wmasterj/Minai-Printer/hardware/enclosure/viewer.html

# Minai Printer enclosure

rev 0.1

Closed Lid open Inside Exploded

Drag to rotate · scroll or pinch to zoom · right-drag to pan

## Pose

Lid angle 0° Pull apart 0% See-through shell Outline edges

## Parts

## Read this first

- The print mechanism is a stand-in block (70 × 31 × 16 mm, assumed). Its posts, the paper slot and the platen roller position must be redrawn around the real part.
- Paper path: roll in the front bay, up past the mechanism, out of the slot on top, torn against the serrated bar.
- The button is translucent and is lit from below by the board's LED.
- USB-C is on the back, lined up with the socket on the board.
