wmasterj/Minai-Printer/hardware/outputs/board-3d-bottom.png

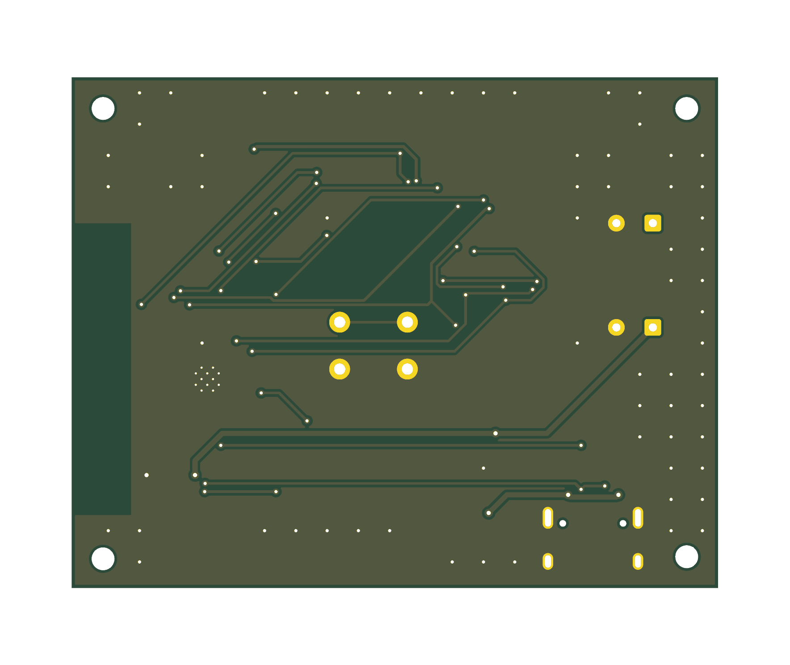
hardware/outputs/board-3d-bottom.png
