wmasterj/Minai-Printer/hardware/outputs/bom.md

| Designators | Qty | Value | Description | Part number | Links |
|---|---|---|---|---|---|
| C1 | 1 | 22uF | Capacitor 22uF 10V X5R 0805 | generic | [LCSC](https://www.lcsc.com/search?q=22uF%200805%20capacitor) · [DigiKey](https://www.digikey.com/en/products/result?keywords=22uF%200805%20capacitor) |
| C2 | 1 | 100uF 10V | Aluminium electrolytic 100uF 10V, 6.3x5.4 mm SMD | generic | [LCSC](https://www.lcsc.com/search?q=100uF%2010V%20Elec%20capacitor) · [DigiKey](https://www.digikey.com/en/products/result?keywords=100uF%2010V%20Elec%20capacitor) |
| C3 C7 | 2 | 1uF | Capacitor 1uF 16V X7R 0603 | generic | [LCSC](https://www.lcsc.com/search?q=1uF%200603%20capacitor) · [DigiKey](https://www.digikey.com/en/products/result?keywords=1uF%200603%20capacitor) |
| C4 C6 C13 C19 | 4 | 10uF | Capacitor 10uF 10V X5R 0805 | generic | [LCSC](https://www.lcsc.com/search?q=10uF%200805%20capacitor) · [DigiKey](https://www.digikey.com/en/products/result?keywords=10uF%200805%20capacitor) |
| C5 C8 C9 C10 C14 C15 C17 C18 C20 C23 | 10 | 100nF | Capacitor 100nF 16V X7R 0603 | generic | [LCSC](https://www.lcsc.com/search?q=100nF%200603%20capacitor) · [DigiKey](https://www.digikey.com/en/products/result?keywords=100nF%200603%20capacitor) |
| C11 C12 | 2 | 1000uF | Aluminium electrolytic 1000uF 10V low-ESR, 8 mm dia, 3.5 mm pitch | generic | [LCSC](https://www.lcsc.com/search?q=1000uF%20Radial%20capacitor) · [DigiKey](https://www.digikey.com/en/products/result?keywords=1000uF%20Radial%20capacitor) |
| C21 | 1 | 2.2uF | Capacitor 2.2uF 16V X7R 0603 | generic | [LCSC](https://www.lcsc.com/search?q=2.2uF%200603%20capacitor) · [DigiKey](https://www.digikey.com/en/products/result?keywords=2.2uF%200603%20capacitor) |
| C22 | 1 | 10nF | Capacitor 10nF 16V X7R (charge pump) | generic | [LCSC](https://www.lcsc.com/search?q=10nF%200603%20capacitor) · [DigiKey](https://www.digikey.com/en/products/result?keywords=10nF%200603%20capacitor) |
| D1 | 1 | B5819W | Schottky diode 40V 1A SOD-123 | B5819W | [LCSC](https://www.lcsc.com/search?q=B5819W) · [DigiKey](https://www.digikey.com/en/products/result?keywords=B5819W) |
| D2 | 1 | SK6812MINI | Addressable RGB LED 3535 | SK6812MINI | [LCSC](https://www.lcsc.com/search?q=SK6812MINI) · [DigiKey](https://www.digikey.com/en/products/result?keywords=SK6812MINI) |
| F1 | 1 | 2.6A PTC | Resettable fuse, 2.6 A hold, 1812 | 1812L260/16 | [LCSC](https://www.lcsc.com/search?q=1812L260) · [DigiKey](https://www.digikey.com/en/products/result?keywords=1812L260) |
| J1 | 1 | USB-C 16P | USB Type-C receptacle, 16 pin, USB 2.0, SMT | TYPE-C-31-M-12 | [LCSC](https://www.lcsc.com/search?q=TYPE-C-31-M-12) · [DigiKey](https://www.digikey.com/en/products/result?keywords=TYPE-C-31-M-12) |
| J2 | 1 | FTP-628MCL101 / PT486F | FFC/FPC connector 30 pos 1.0 mm pitch, right angle ZIF | 200528-0300 (Fujitsu specifies Molex 52610-3071) | [LCSC](https://www.lcsc.com/search?q=200528-0300) · [DigiKey](https://www.digikey.com/en/products/result?keywords=200528-0300) |
| Q1 | 1 | AO3401A | P-channel MOSFET 30V 4A, VH high-side switch | AO3401A | [LCSC](https://www.lcsc.com/search?q=AO3401A) · [DigiKey](https://www.digikey.com/en/products/result?keywords=AO3401A) |
| Q2 | 1 | 2N7002 | N-channel MOSFET 60V, level shifter | 2N7002 | [LCSC](https://www.lcsc.com/search?q=2N7002) · [DigiKey](https://www.digikey.com/en/products/result?keywords=2N7002) |
| R1 R2 | 2 | 5.1k | Resistor 5.1k 0603 | generic | [LCSC](https://www.lcsc.com/search?q=5.1k%200603%20resistor) · [DigiKey](https://www.digikey.com/en/products/result?keywords=5.1k%200603%20resistor) |
| R3 R4 R5 R6 R7 R8 R9 | 7 | 10k | Resistor 10k 0603 | generic | [LCSC](https://www.lcsc.com/search?q=10k%200603%20resistor) · [DigiKey](https://www.digikey.com/en/products/result?keywords=10k%200603%20resistor) |
| R10 | 1 | 150k | Resistor 150k 0603 | generic | [LCSC](https://www.lcsc.com/search?q=150k%200603%20resistor) · [DigiKey](https://www.digikey.com/en/products/result?keywords=150k%200603%20resistor) |
| R11 | 1 | 1M | Resistor 1M 0603 | generic | [LCSC](https://www.lcsc.com/search?q=1M%200603%20resistor) · [DigiKey](https://www.digikey.com/en/products/result?keywords=1M%200603%20resistor) |
| R12 | 1 | 100k 1% | Resistor 100k 1% 0603 | generic | [LCSC](https://www.lcsc.com/search?q=100k%200603%20resistor) · [DigiKey](https://www.digikey.com/en/products/result?keywords=100k%200603%20resistor) |
| R13 | 1 | 68k 1% | Resistor 68k 1% 0603 | generic | [LCSC](https://www.lcsc.com/search?q=68k%200603%20resistor) · [DigiKey](https://www.digikey.com/en/products/result?keywords=68k%200603%20resistor) |
| R14 | 1 | 220R | Resistor 220R (paper sensor LED current) | generic | [LCSC](https://www.lcsc.com/search?q=220R%200603%20resistor) · [DigiKey](https://www.digikey.com/en/products/result?keywords=220R%200603%20resistor) |
| R15 | 1 | 47k | Resistor 47k (paper sensor load) | generic | [LCSC](https://www.lcsc.com/search?q=47k%200603%20resistor) · [DigiKey](https://www.digikey.com/en/products/result?keywords=47k%200603%20resistor) |
| R16 | 1 | 30k 1% | Resistor 30k 1% (thermistor divider) | generic | [LCSC](https://www.lcsc.com/search?q=30k%200603%20resistor) · [DigiKey](https://www.digikey.com/en/products/result?keywords=30k%200603%20resistor) |
| R17 R18 | 2 | 0.2R | Current-sense resistor 0.2 ohm 1% 0805 (1 A limit) | generic | [LCSC](https://www.lcsc.com/search?q=0.2R%200805%20resistor) · [DigiKey](https://www.digikey.com/en/products/result?keywords=0.2R%200805%20resistor) |
| SW1 | 1 | BTN / BOOT | Tactile switch 6x6 mm through-hole; actuator height to suit keycap | TS-1187 / B3F class | [LCSC](https://www.lcsc.com/search?q=TS-1187) · [DigiKey](https://www.digikey.com/en/products/result?keywords=TS-1187) |
| U1 | 1 | ESP32-C3-WROOM-02-N4 | Wi-Fi + Bluetooth LE module, RISC-V, 4 MB flash, PCB antenna | ESP32-C3-WROOM-02-N4 | [maker](https://www.espressif.com/en/products/modules/esp32-c3) · [LCSC](https://www.lcsc.com/search?q=ESP32-C3-WROOM-02-N4) · [DigiKey](https://www.digikey.com/en/products/result?keywords=ESP32-C3-WROOM-02-N4) |
| U2 | 1 | AP2112K-3.3 | 3.3 V 600 mA low-dropout regulator | AP2112K-3.3TRG1 | [maker](https://www.diodes.com/part/view/AP2112) · [LCSC](https://www.lcsc.com/search?q=AP2112K-3.3TRG1) · [DigiKey](https://www.digikey.com/en/products/result?keywords=AP2112K-3.3TRG1) |
| U3 | 1 | DRV8833PW | Dual H-bridge motor driver, 1.5 A, TSSOP-16 | DRV8833PWR | [maker](https://www.ti.com/product/DRV8833) · [LCSC](https://www.lcsc.com/search?q=DRV8833PWR) · [DigiKey](https://www.digikey.com/en/products/result?keywords=DRV8833PWR) |
| U4 | 1 | 74LVC2G04 | Dual inverter, generates complementary motor phase signals | 74LVC2G04GW | [maker](https://www.nexperia.com/product/74LVC2G04GW) · [LCSC](https://www.lcsc.com/search?q=74LVC2G04GW) · [DigiKey](https://www.digikey.com/en/products/result?keywords=74LVC2G04GW) |
| U5 | 1 | USBLC6-2SC6 | USB ESD protection diode array | USBLC6-2SC6 | [maker](https://www.st.com/en/protection-devices/usblc6-2.html) · [LCSC](https://www.lcsc.com/search?q=USBLC6-2SC6) · [DigiKey](https://www.digikey.com/en/products/result?keywords=USBLC6-2SC6) |
