wmasterj/Minai-Printer/hardware/enclosure/out/minai-printer-assembly.step

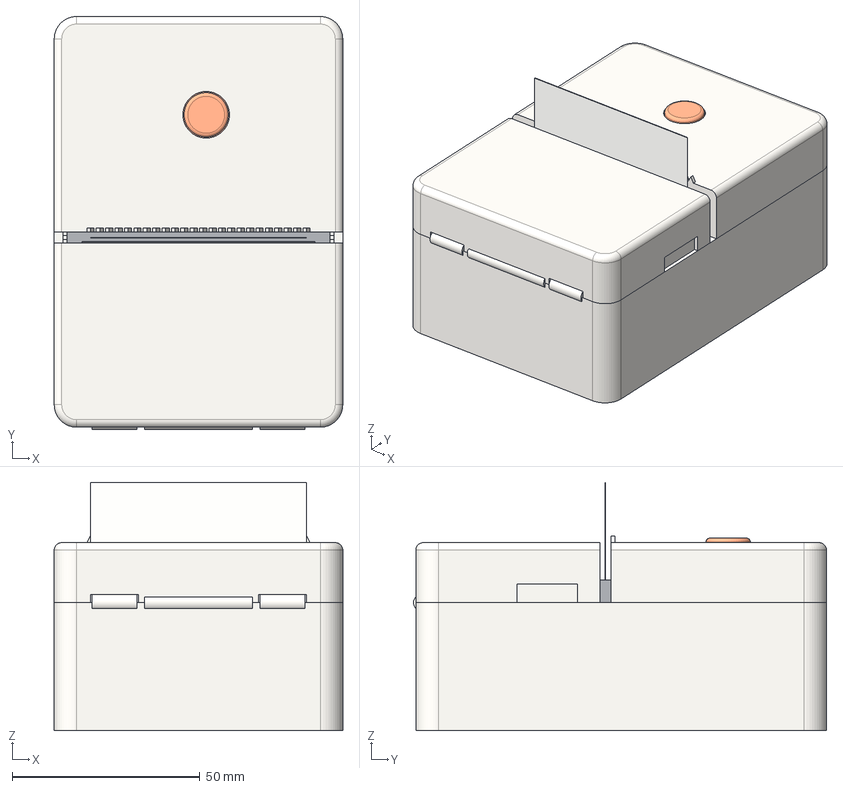
[picture p10: CAD file, 2026-11-10]
hardware/enclosure/out/minai-printer-assembly.step
76.8 x 109.9 x 66.0 mm
base
lid
rear-cover
button
platen-roller
main-board
board-parts
print-mechanism
paper-roll
paper
