wmasterj/Minai-Printer/hardware/enclosure/out/base.step

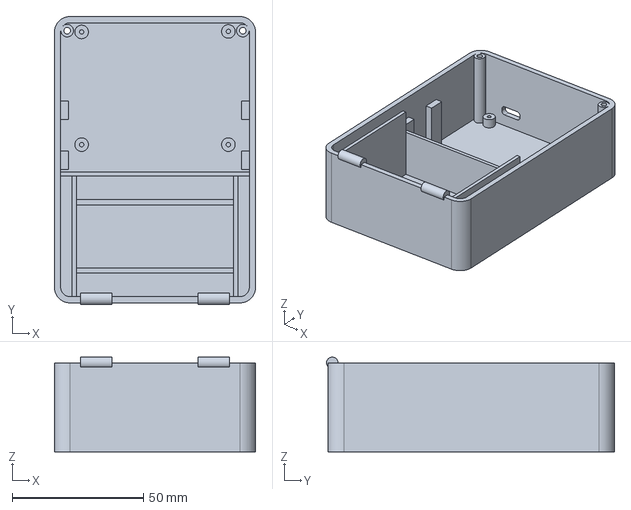
[picture p11: CAD file, 2026-11-10]
hardware/enclosure/out/base.step
76.8 x 109.9 x 36.2 mm
