wmasterj/Minai-Printer/hardware/enclosure/out/lid.step

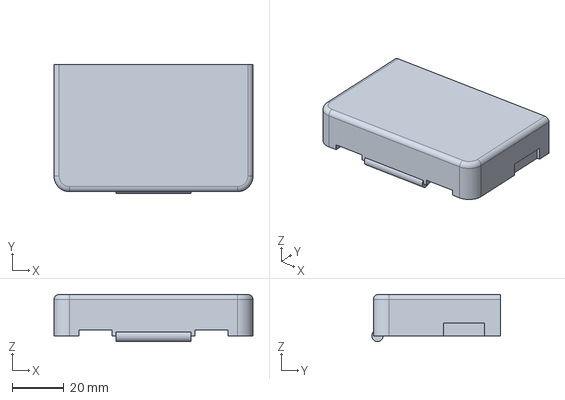
[picture p12: CAD file, 2026-11-10]
hardware/enclosure/out/lid.step
76.8 x 49.6 x 18.2 mm
