wmasterj/Minai-Printer/hardware/enclosure/out/button.step

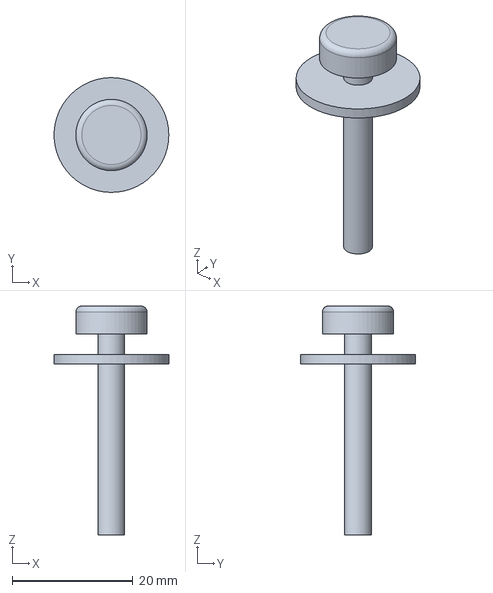
[picture p13: CAD file, 2026-11-10]
hardware/enclosure/out/button.step
19.0 x 19.0 x 37.9 mm
