wmasterj/Minai-Printer/hardware/enclosure/out/rear-cover.step

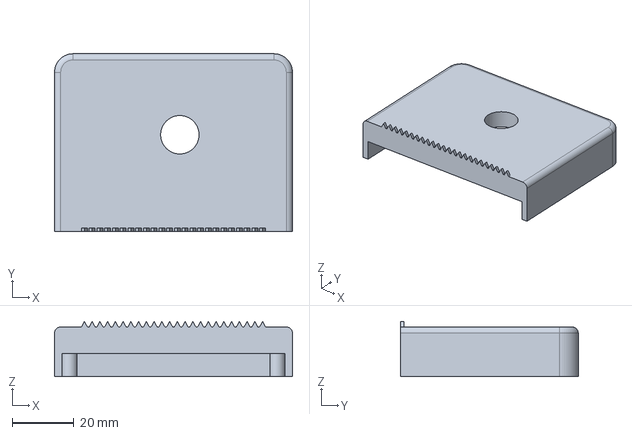
[picture p14: CAD file, 2026-11-10]
hardware/enclosure/out/rear-cover.step
76.8 x 57.3 x 17.8 mm
