wmasterj/Minai-Printer/(list of files, cad)

Other CAD files:
hardware/enclosure/out/base.stl
hardware/enclosure/out/button.stl
hardware/enclosure/out/lid.stl
hardware/enclosure/out/rear-cover.stl
