wmasterj/Minai-Printer/hardware/outputs/schematic.pdf

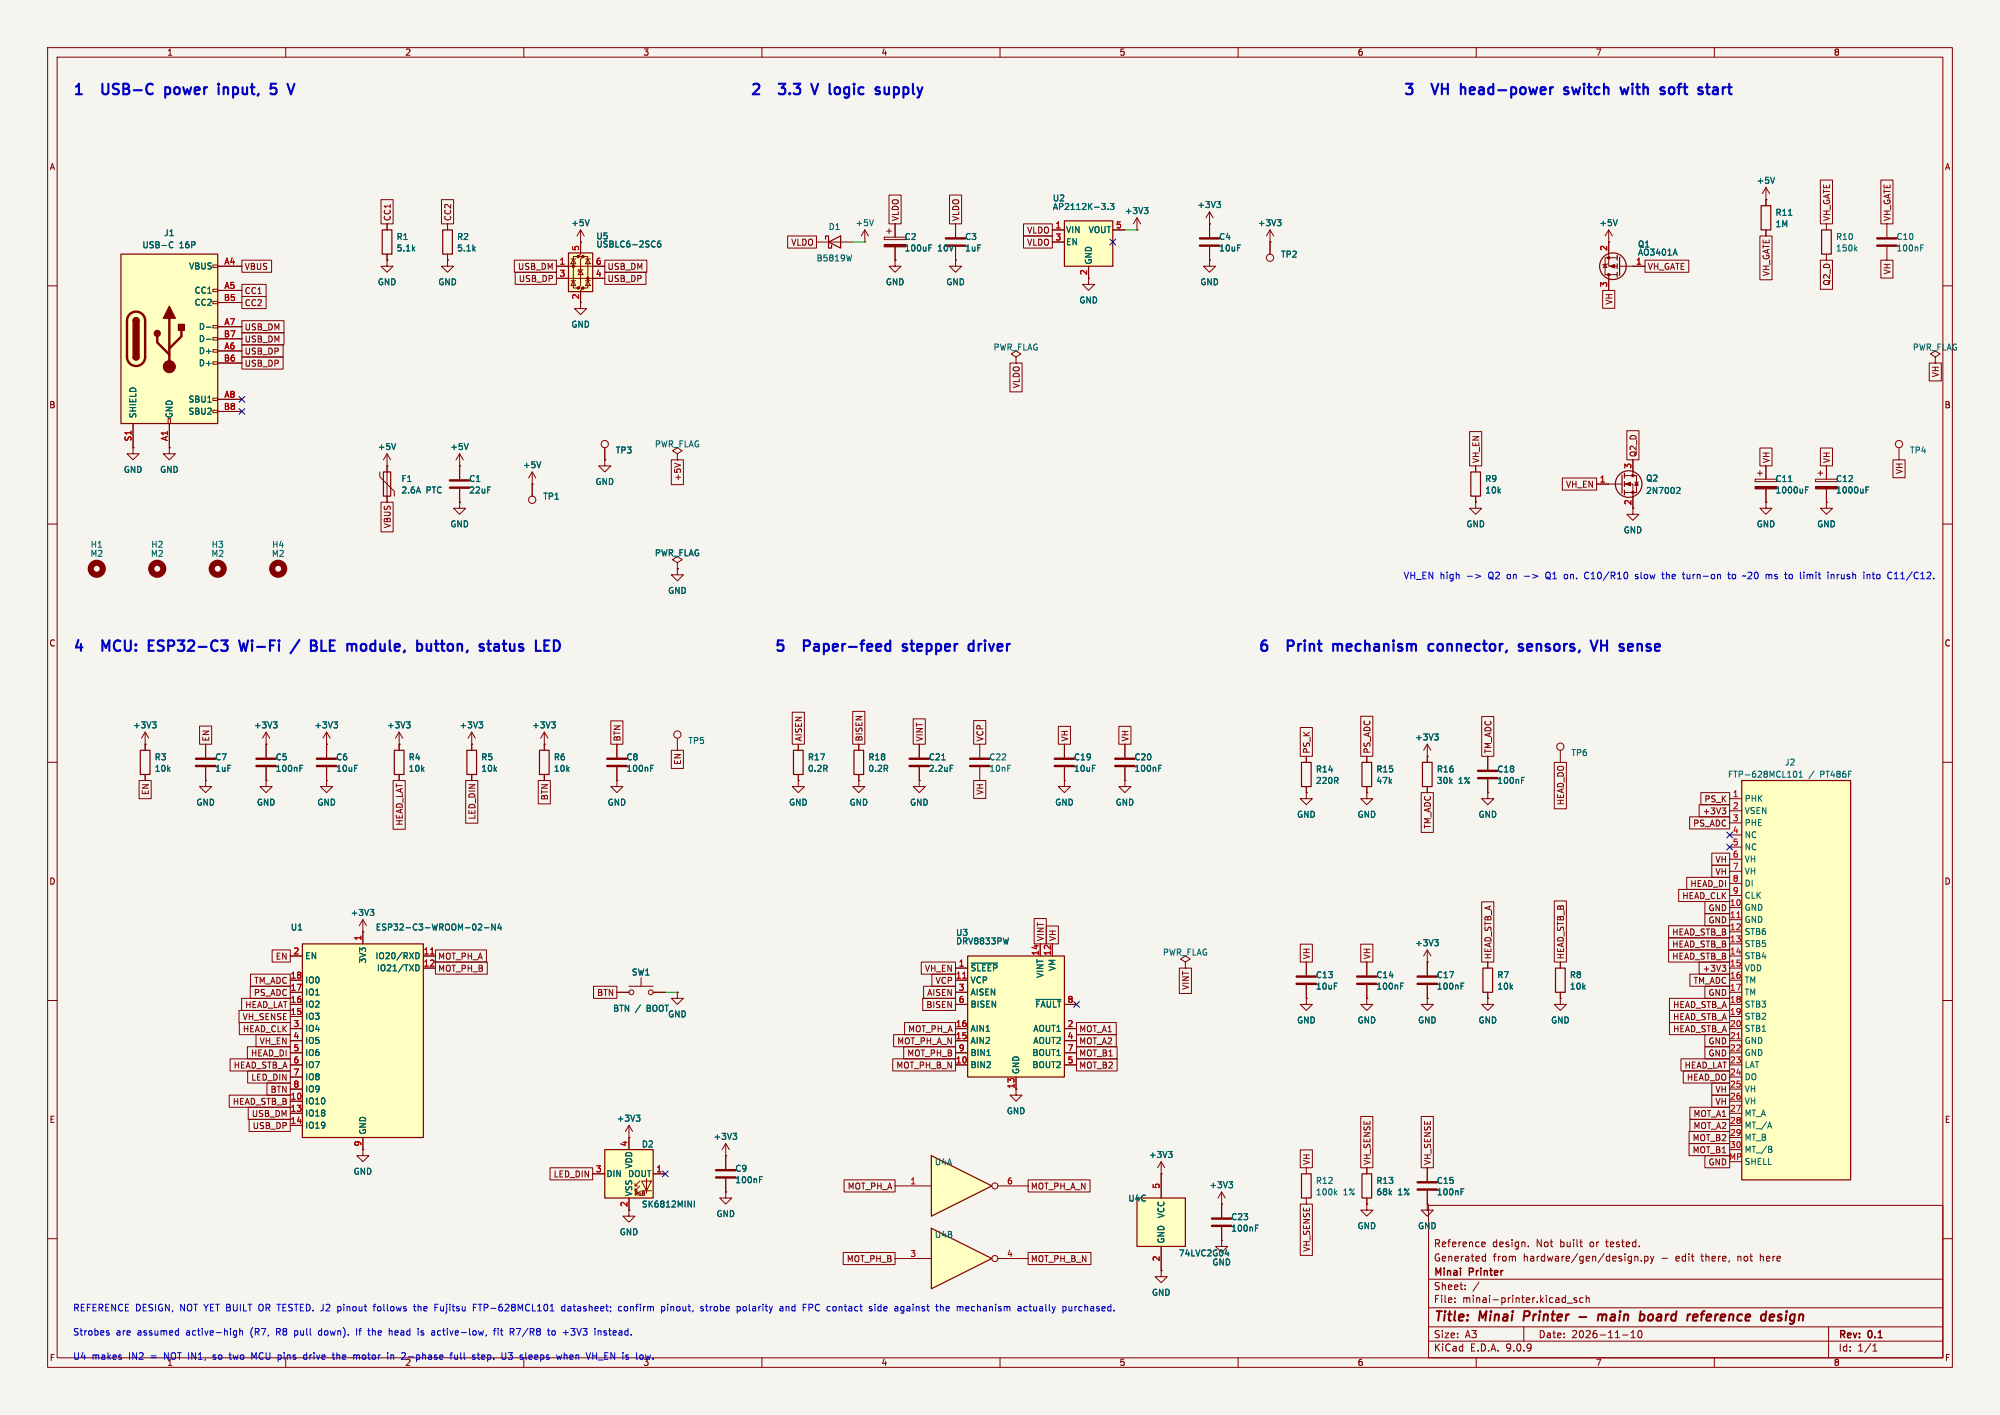
[picture p15: page 1]

Id: 1/1 Title: Minai Printer - main board reference design
