wmasterj/Minai-Printer/hardware/outputs/board-bottom.pdf

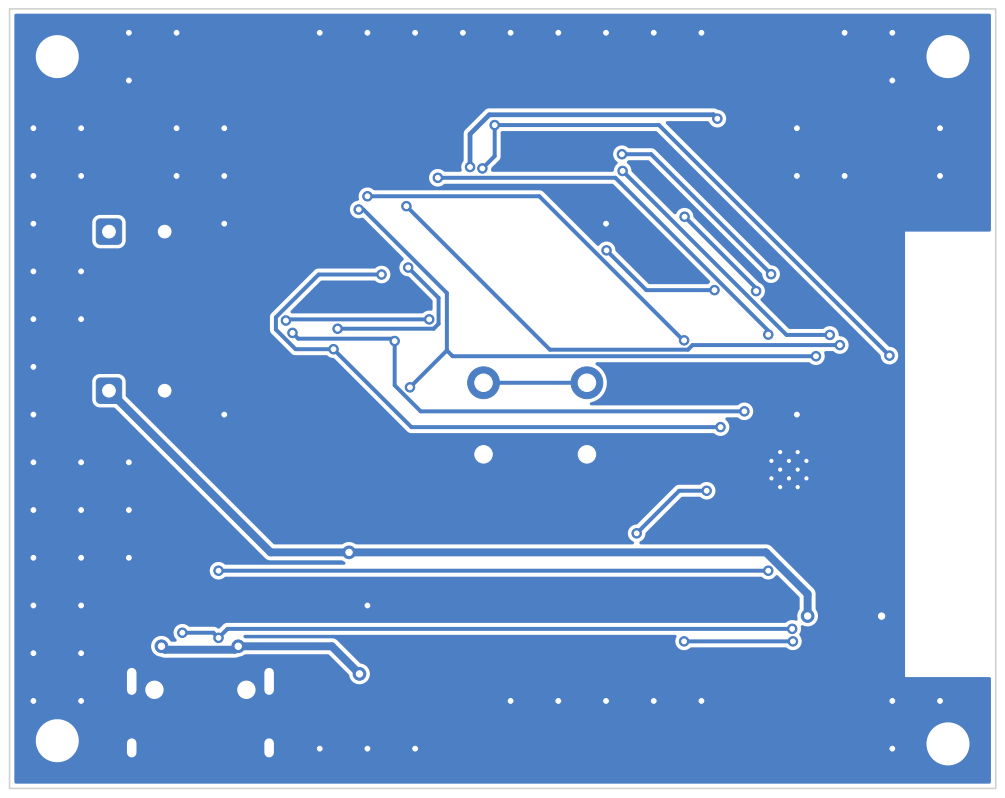
[picture p16: page 1]
