wmasterj/Minai-Printer/hardware/outputs/board-top.pdf

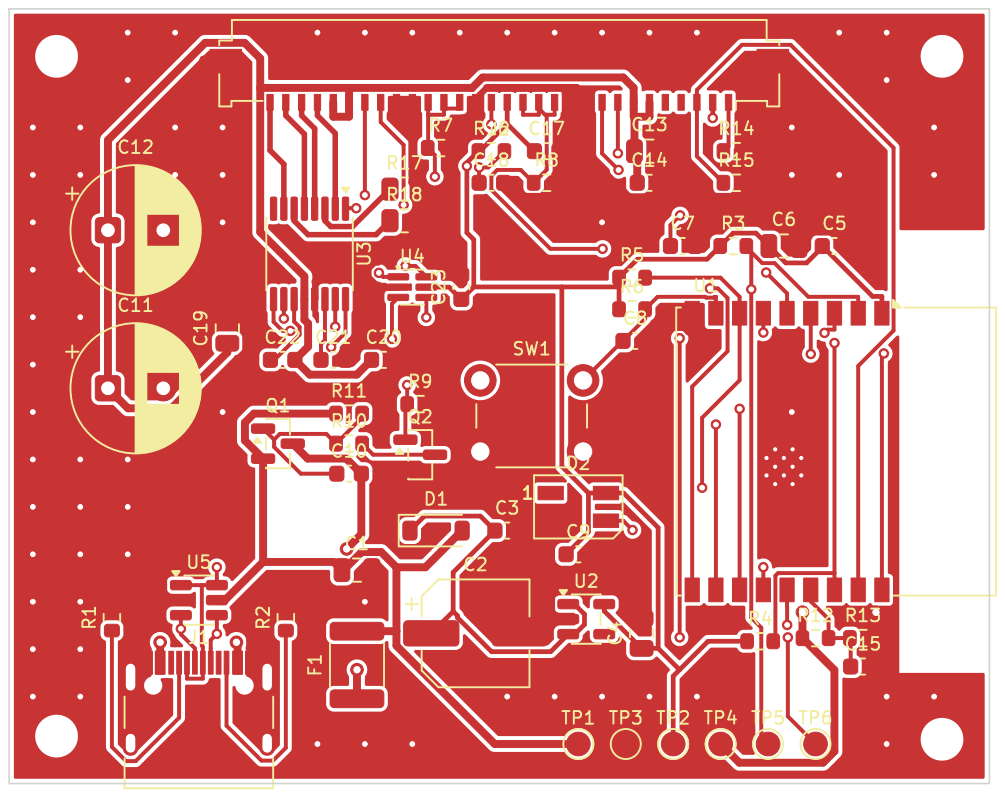
[picture p17: page 1]
