wmasterj/Minai-Printer/hardware/kicad/minai-printer.kicad_pcb

## KiCad design hardware/kicad/minai-printer.kicad_pcb (2026-11-10)

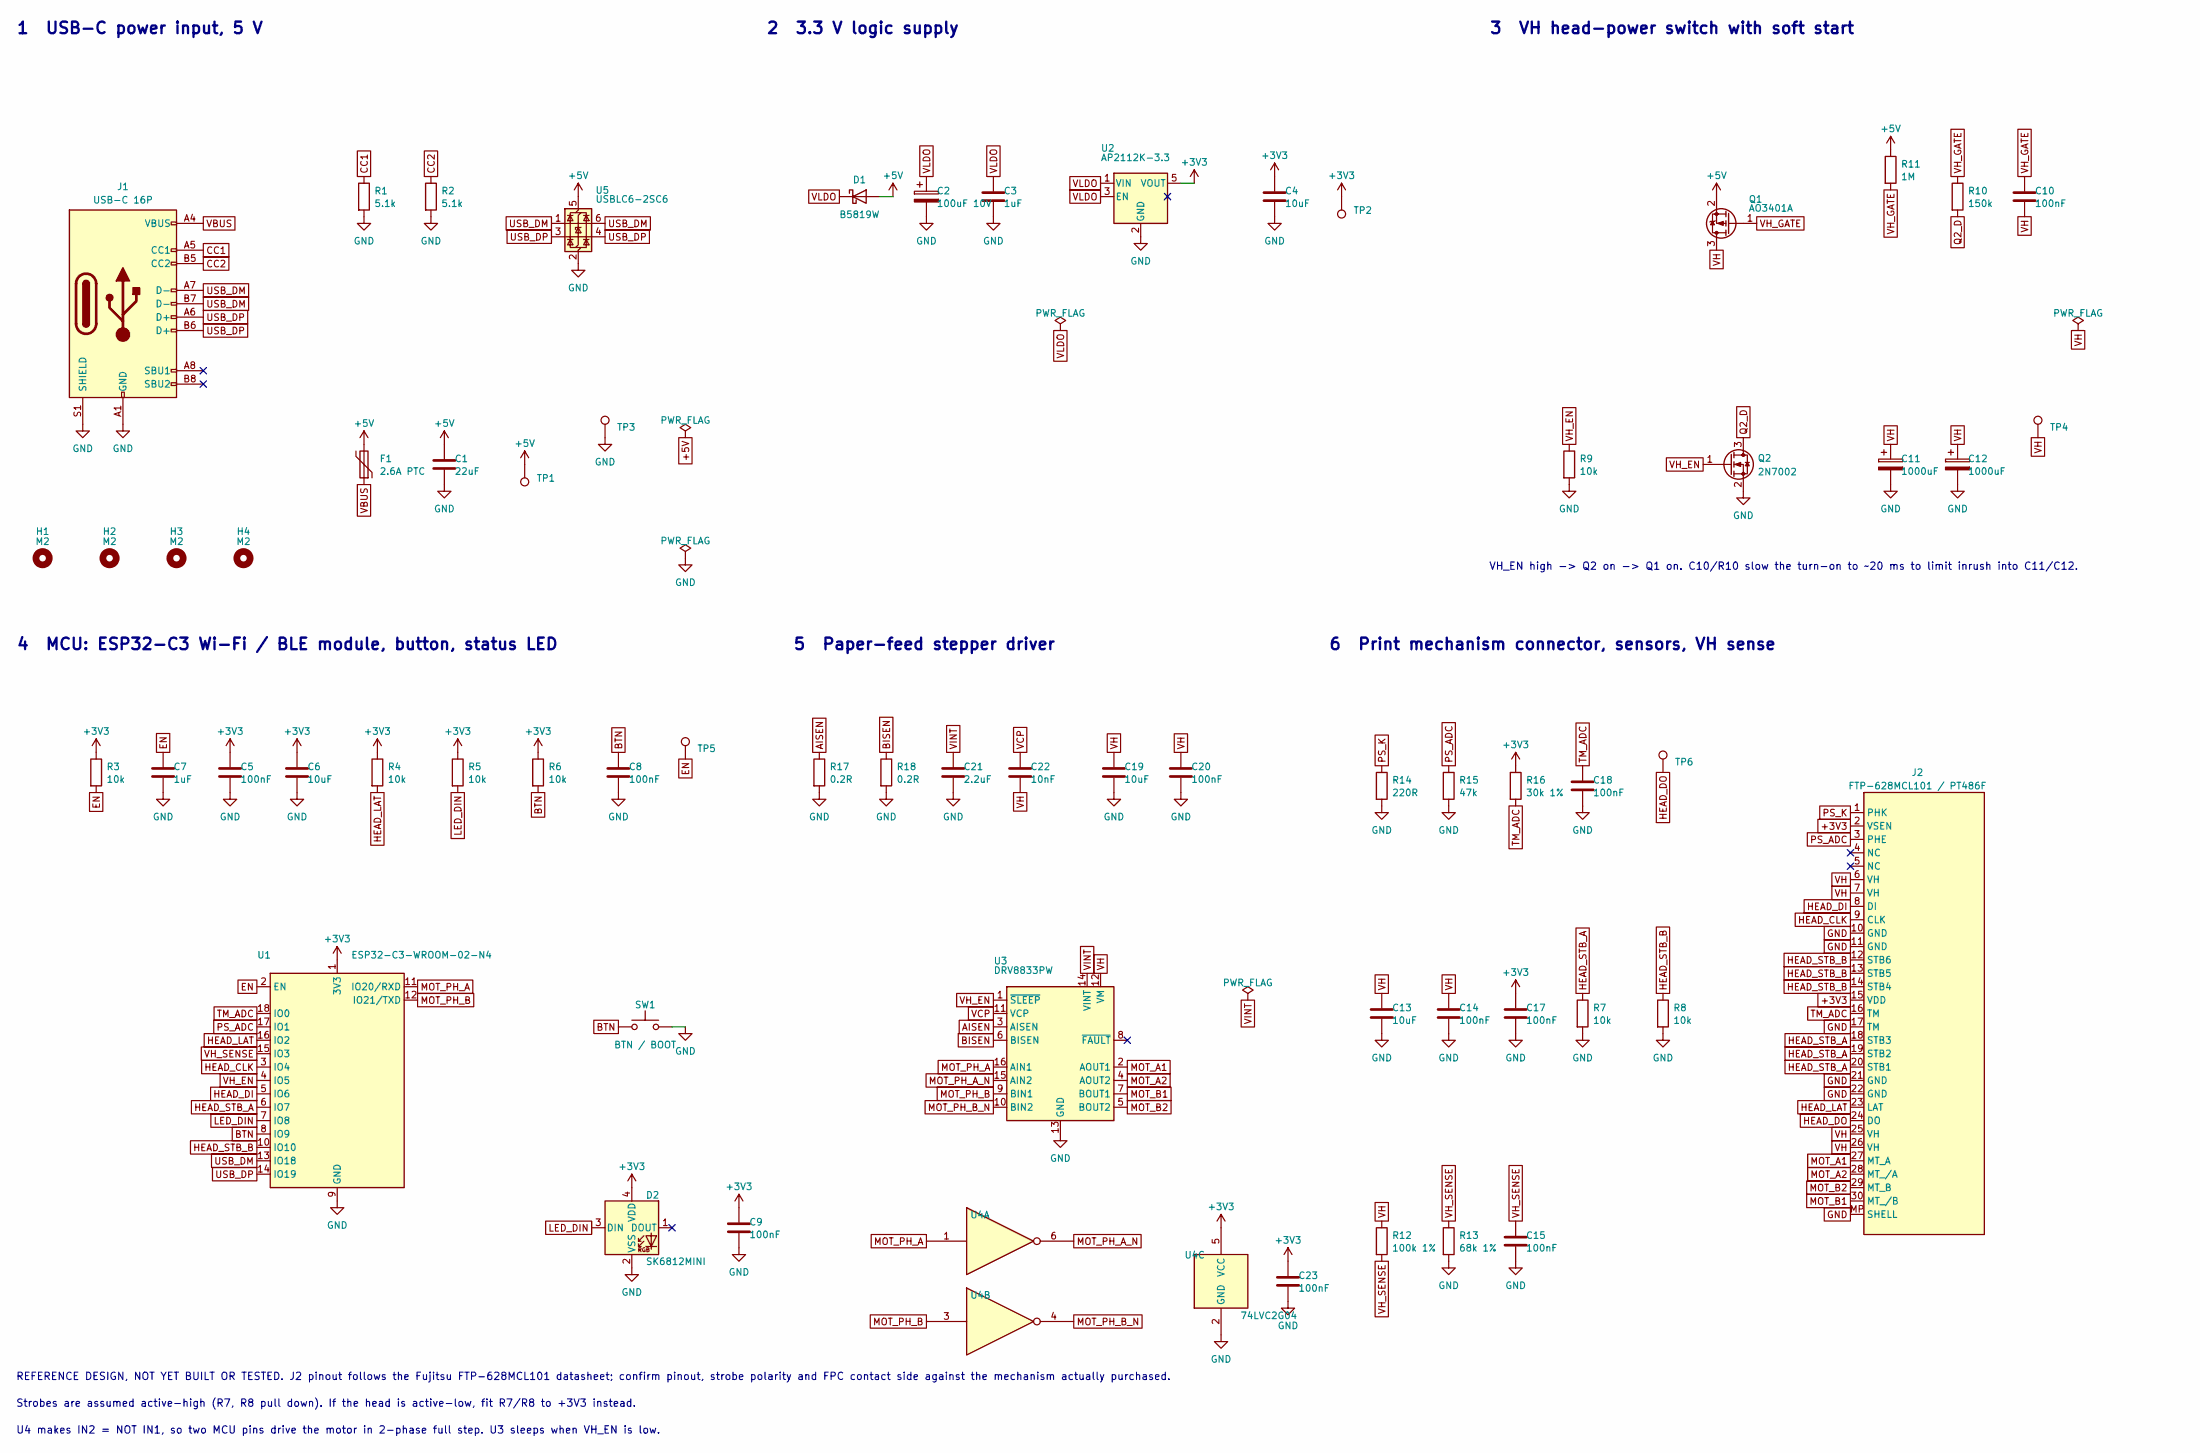
[picture p18: schematic minai-printer.kicad_sch, Minai Printer - main board reference design]

Parts:
C1: 22uF; C_0805_2012Metric
C2: 100uF 10V; CP_Elec_6.3x5.4
C3, C7: 1uF; C_0603_1608Metric
C4, C6, C13, C19: 10uF; C_0805_2012Metric
C5, C8, C9, C10, C14, C15, C17, C18, C20, C23: 100nF; C_0603_1608Metric
C11, C12: 1000uF; CP_Radial_D8.0mm_P3.50mm
C21: 2.2uF; C_0603_1608Metric
C22: 10nF; C_0603_1608Metric
D1: B5819W; D_SOD-123; MPN B5819W
D2: SK6812MINI; LED_SK6812MINI_PLCC4_3.5x3.5mm_P1.75mm; MPN SK6812MINI
F1: 2.6A PTC; Fuse_1812_4532Metric; MPN 1812L260/16
H1, H2, H3, H4: M2; MountingHole_2.2mm_M2
J1: USB-C 16P; USB_C_Receptacle_HRO_TYPE-C-31-M-12; MPN TYPE-C-31-M-12
J2: FTP-628MCL101 / PT486F; Molex_200528-0300_1x30-1MP_P1.00mm_Horizontal; MPN 200528-0300 (Fujitsu specifies Molex 52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
Q1: AO3401A; SOT-23; MPN AO3401A
Q2: 2N7002; SOT-23; MPN 2N7002
R1, R2: 5.1k; R_0603_1608Metric
R3, R4, R5, R6, R7, R8, R9: 10k; R_0603_1608Metric
R10: 150k; R_0603_1608Metric
R11: 1M; R_0603_1608Metric
R12: 100k 1%; R_0603_1608Metric
R13: 68k 1%; R_0603_1608Metric
R14: 220R; R_0603_1608Metric
R15: 47k; R_0603_1608Metric
R16: 30k 1%; R_0603_1608Metric
R17, R18: 0.2R; R_0805_2012Metric
SW1: BTN / BOOT; SW_PUSH_6mm; MPN TS-1187 / B3F class
TP1: +5V; TestPoint_Pad_D1.5mm
TP2: +3V3; TestPoint_Pad_D1.5mm
TP3: GND; TestPoint_Pad_D1.5mm
TP4: VH; TestPoint_Pad_D1.5mm
TP5: EN; TestPoint_Pad_D1.5mm
TP6: HEAD_DO; TestPoint_Pad_D1.5mm
U1: ESP32-C3-WROOM-02-N4; ESP32-C3-WROOM-02; MPN ESP32-C3-WROOM-02-N4
U2: AP2112K-3.3; SOT-23-5; MPN AP2112K-3.3TRG1
U3: DRV8833PW; TSSOP-16_4.4x5mm_P0.65mm; MPN DRV8833PWR
U4: 74LVC2G04; SOT-363_SC-70-6; MPN 74LVC2G04GW
U5: USBLC6-2SC6; SOT-23-6; MPN USBLC6-2SC6

Connections:
+3V3: C4.1, C5.1, C6.1, C9.1, C17.1, C23.1, D2.4 (VDD), J2.2 (VSEN), J2.15 (VDD), R3.1, R4.1, R5.1, R6.1, R16.1, TP2.1, U1.1 (3V3), U2.5 (VOUT), U4.5 (VCC)
+5V: C1.1, D1.2 (A), F1.2, Q1.2 (S), R11.1, TP1.1, U5.5 (VBUS)
AISEN: R17.1, U3.3 (AISEN)
BISEN: R18.1, U3.6 (BISEN)
BTN: C8.1, R6.2, SW1.1, U1.8 (IO9)
CC1: J1.A5 (CC1), R1.1
CC2: J1.B5 (CC2), R2.1
EN: C7.1, R3.2, TP5.1, U1.2 (EN)
GND: C1.2, C2.2, C3.2, C4.2, C5.2, C6.2, C7.2, C8.2, C9.2, C11.2, C12.2, C13.2, C14.2, C15.2, C17.2, C18.2, C19.2, C20.2, C21.2, C23.2, D2.2 (VSS), J1.A1 (GND), J1.A12 (GND), J1.B1 (GND), J1.B12 (GND), J1.S1 (SHIELD), J2.10 (GND), J2.11 (GND), J2.17 (TM), J2.21 (GND), J2.22 (GND), J2.MP (SHELL), Q2.2 (S), R1.2, R2.2, R7.2, R8.2, R9.2, R13.2, R14.2, R15.2, R17.2, R18.2, SW1.2, TP3.1, U1.9 (GND), U1.19 (GND), U2.2 (GND), U3.13 (GND), U4.2 (GND), U5.2 (GND)
HEAD_CLK: J2.9 (CLK), U1.3 (IO4)
HEAD_DI: J2.8 (DI), U1.5 (IO6)
HEAD_DO: J2.24 (DO), TP6.1
HEAD_LAT: J2.23 (LAT), R4.2, U1.16 (IO2)
HEAD_STB_A: J2.18 (STB3), J2.19 (STB2), J2.20 (STB1), R7.1, U1.6 (IO7)
HEAD_STB_B: J2.12 (STB6), J2.13 (STB5), J2.14 (STB4), R8.1, U1.10 (IO10)
LED_DIN: D2.3 (DIN), R5.2, U1.7 (IO8)
MOT_A1: J2.27 (MT_A), U3.2 (AOUT1)
MOT_A2: J2.28 (MT_/A), U3.4 (AOUT2)
MOT_B1: J2.30 (MT_/B), U3.7 (BOUT1)
MOT_B2: J2.29 (MT_B), U3.5 (BOUT2)
MOT_PH_A: U1.11 (IO20/RXD), U3.16 (AIN1), U4.1
MOT_PH_A_N: U3.15 (AIN2), U4.6
MOT_PH_B: U1.12 (IO21/TXD), U3.9 (BIN1), U4.3
MOT_PH_B_N: U3.10 (BIN2), U4.4
PS_ADC: J2.3 (PHE), R15.1, U1.17 (IO1)
PS_K: J2.1 (PHK), R14.1
Q2_D: Q2.3 (D), R10.2
TM_ADC: C18.1, J2.16 (TM), R16.2, U1.18 (IO0)
USB_DM: J1.A7 (D-), J1.B7 (D-), U1.13 (IO18), U5.1 (I/O1), U5.6 (I/O1)
USB_DP: J1.A6 (D+), J1.B6 (D+), U1.14 (IO19), U5.3 (I/O2), U5.4 (I/O2)
VBUS: F1.1, J1.A4 (VBUS), J1.A9 (VBUS), J1.B4 (VBUS), J1.B9 (VBUS)
VCP: C22.1, U3.11 (VCP)
VH: C10.2, C11.1, C12.1, C13.1, C14.1, C19.1, C20.1, C22.2, J2.6 (VH), J2.7 (VH), J2.25 (VH), J2.26 (VH), Q1.3 (D), R12.1, TP4.1, U3.12 (VM)
VH_EN: Q2.1 (G), R9.1, U1.4 (IO5), U3.1 (~SLEEP)
VH_GATE: C10.1, Q1.1 (G), R10.1, R11.2
VH_SENSE: C15.1, R12.2, R13.1, U1.15 (IO3)
VINT: C21.1, U3.14 (VINT)
VLDO: C2.1, C3.1, D1.1 (K), U2.1 (VIN), U2.3 (EN)

Notes on the sheet:
1 USB-C power input, 5 V
2 3.3 V logic supply
3 VH head-power switch with soft start
4 MCU: ESP32-C3 Wi-Fi / BLE module, button, status LED
5 Paper-feed stepper driver
6 Print mechanism connector, sensors, VH sense
REFERENCE DESIGN, NOT YET BUILT OR TESTED. J2 pinout follows the Fujitsu FTP-628MCL101 datasheet; confirm pinout, strobe polarity and FPC contact side against the mechanism actually purchased.
Strobes are assumed active-high (R7, R8 pull down). If the head is active-low, fit R7/R8 to +3V3 instead.
VH_EN high -> Q2 on -> Q1 on. C10/R10 slow the turn-on to ~20 ms to limit inrush into C11/C12.
U4 makes IN2 = NOT IN1, so two MCU pins drive the motor in 2-phase full step. U3 sleeps when VH_EN is low.

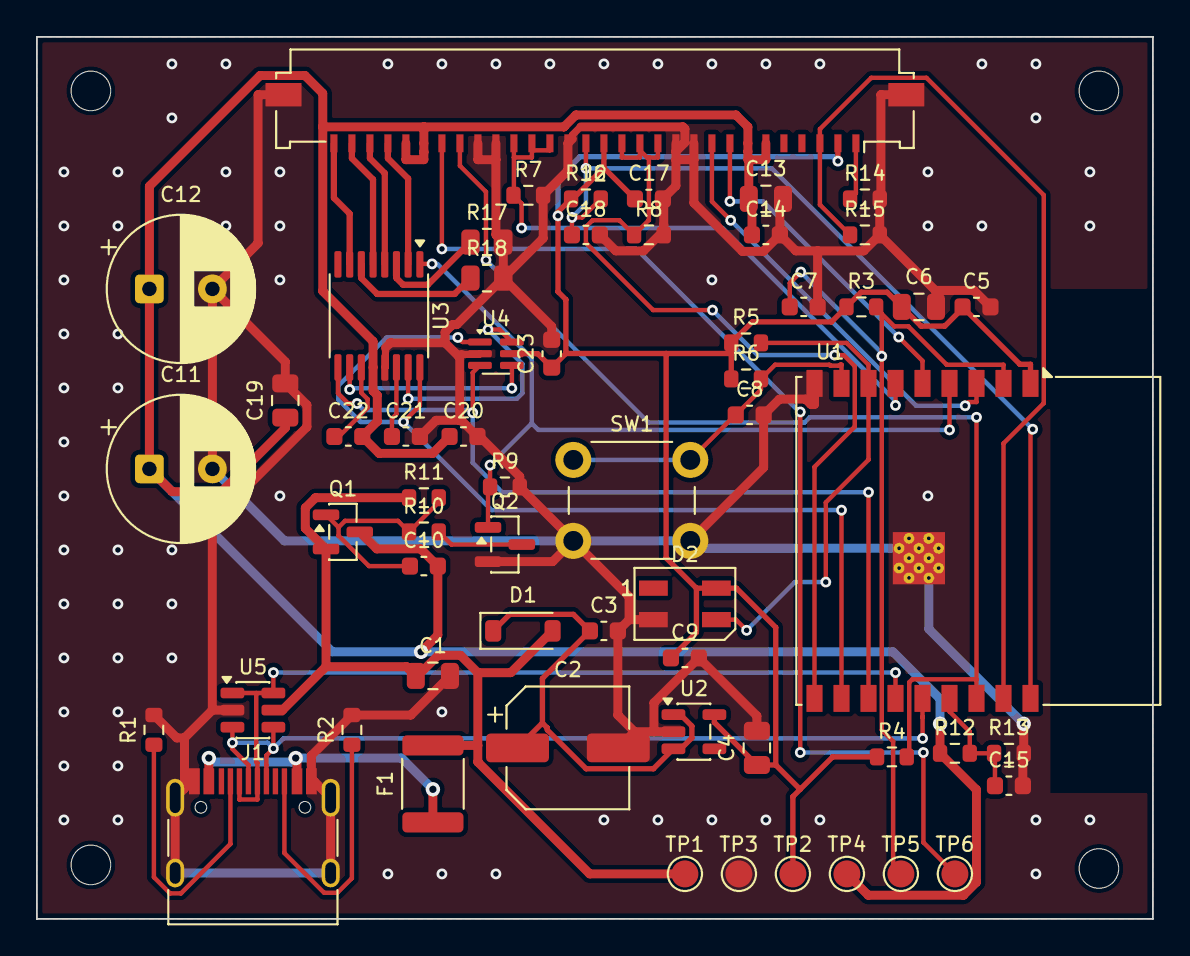
[picture p19: board minai-printer.kicad_pcb from above]

Board: 2 copper layers, 62.0 x 49.0 mm, 63 parts (0 on the bottom side), 38 nets.
