wmasterj/Minai-Printer/(commit log)

2026-11-10 Add first-draft hardware specification for the Minai Printer
    Defines requirements, reference architecture, cost estimate, build plan
    and RFQ checklist for a low-cost 58 mm Wi-Fi thermal printer.
    Claude-Session: https://claude.ai/code/session_01KHZ22pTiawFEdCEYHMGhQF
2026-11-10 Add main board reference design: schematic, routed PCB, gerbers, BOM
    - hardware/gen: design.py holds every part, net and position; scripts
    generate the KiCad 9 schematic and board from it and export outputs
    - hardware/kicad: KiCad project (ERC 0 errors; DRC 0 errors, 0 unconnected,
    schematic parity clean; silkscreen warnings remain)
    - hardware/outputs: schematic PDF/PNG, board renders, gerbers, drill,
    pick-and-place, BOM with supplier search links, rule-check reports
    - Spec updated for decisions: no battery, tear bar, first order 100 units;
    module changed to ESP32-C3-WROOM-02, motor driver to DRV8833 + inverter
    Reference design only: not built or tested. Open checks are listed in
    ha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
    [bom.csv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]
2026-11-10 Add concept enclosure: parametric CAD model, STEP/STL files, 3D viewer
    Four printed parts (base, front-hinged lid with platen roller, rear cover
    with tear bar, light-up button) drawn around the reference board and a
    58 mm paper roll. The print mechanism is an assumed stand-in block, so
    its mounts and the paper slot need redrawing around the real part.
    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
    [base.step, base.stl, button.step, button.stl, lid.step, lid.stl, minai-printer-assembly.step, rear-cover.step]
